EasySensors/ButtonSizeNode/pics/bttnsz.jpg

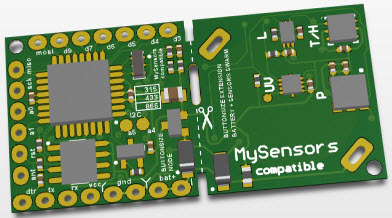
pics/bttnsz.jpg
