EasySensors/ButtonSizeNode/pics/bttnszH.jpg

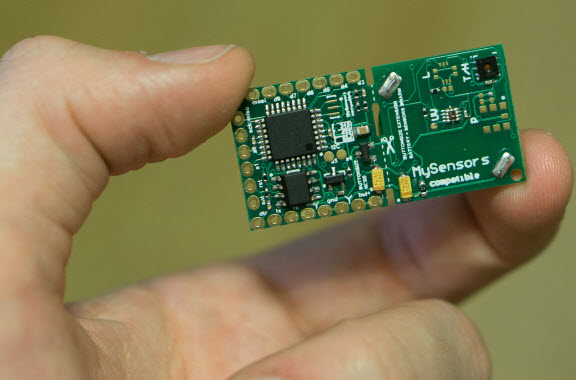
pics/bttnszH.jpg
