EasySensors/ButtonSizeNode/pics/cut.jpg

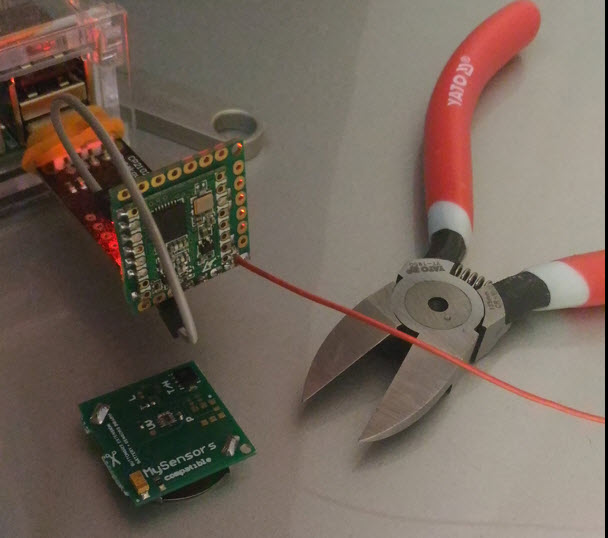
pics/cut.jpg
