EasySensors/ButtonSizeNode/pics/IMG_20180411_230300.jpg

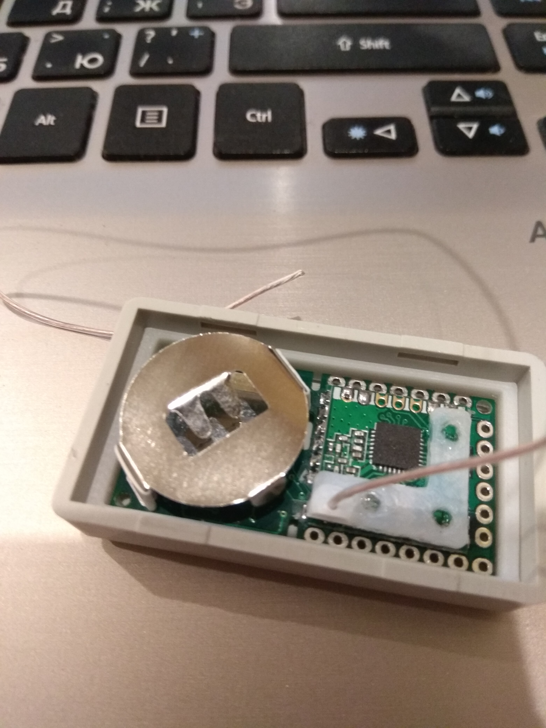
pics/IMG_20180411_230300.jpg
