EasySensors/ButtonSizeNode/pics/IMG_20180411_230850.jpg

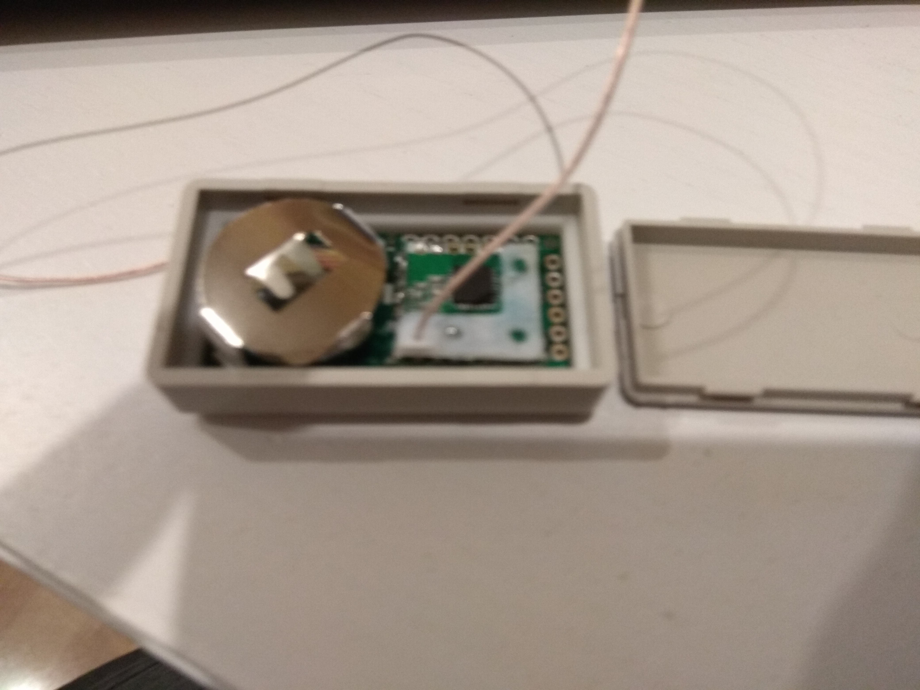
pics/IMG_20180411_230850.jpg
