EasySensors/ButtonSizeNode/pics/IMG_20180411_230931.jpg

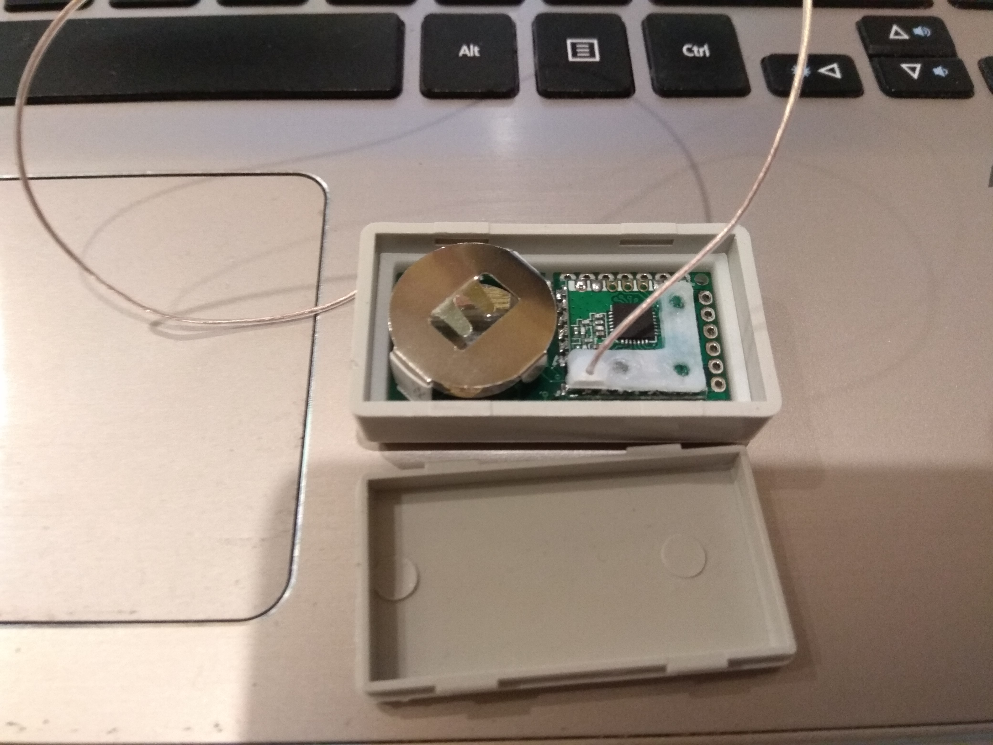
pics/IMG_20180411_230931.jpg
