EasySensors/ButtonSizeNode/pics/IMG_20180411_231010.jpg

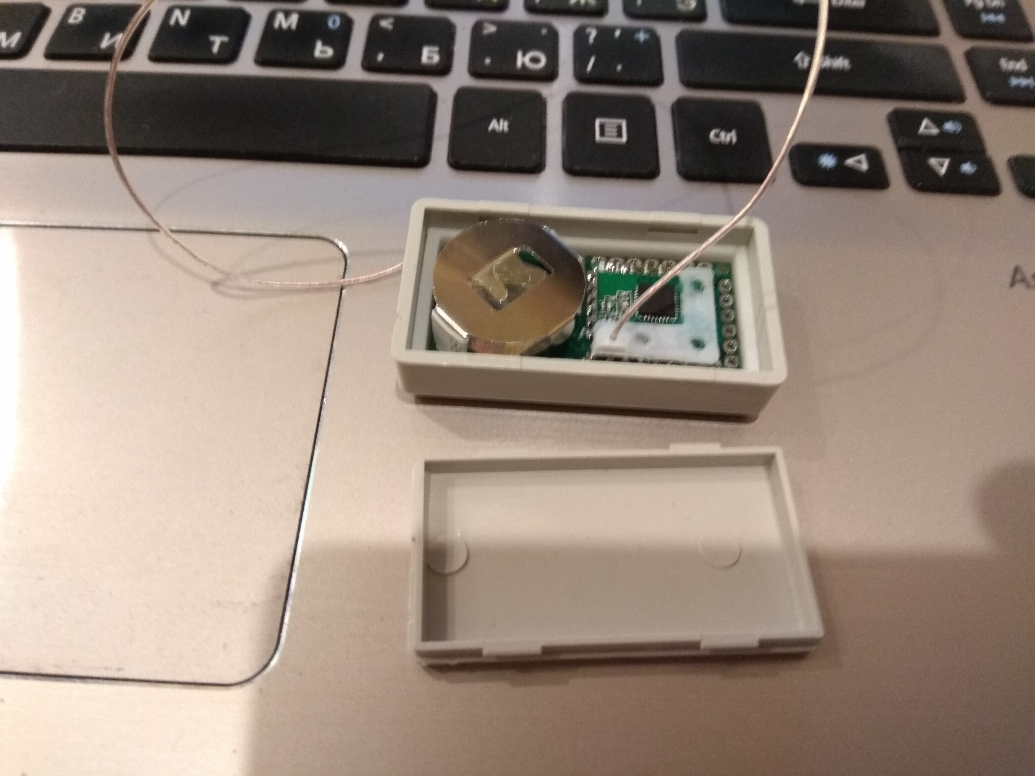
pics/IMG_20180411_231010.jpg
