EasySensors/ButtonSizeNode/pics/IMG_20180411_231150.jpg

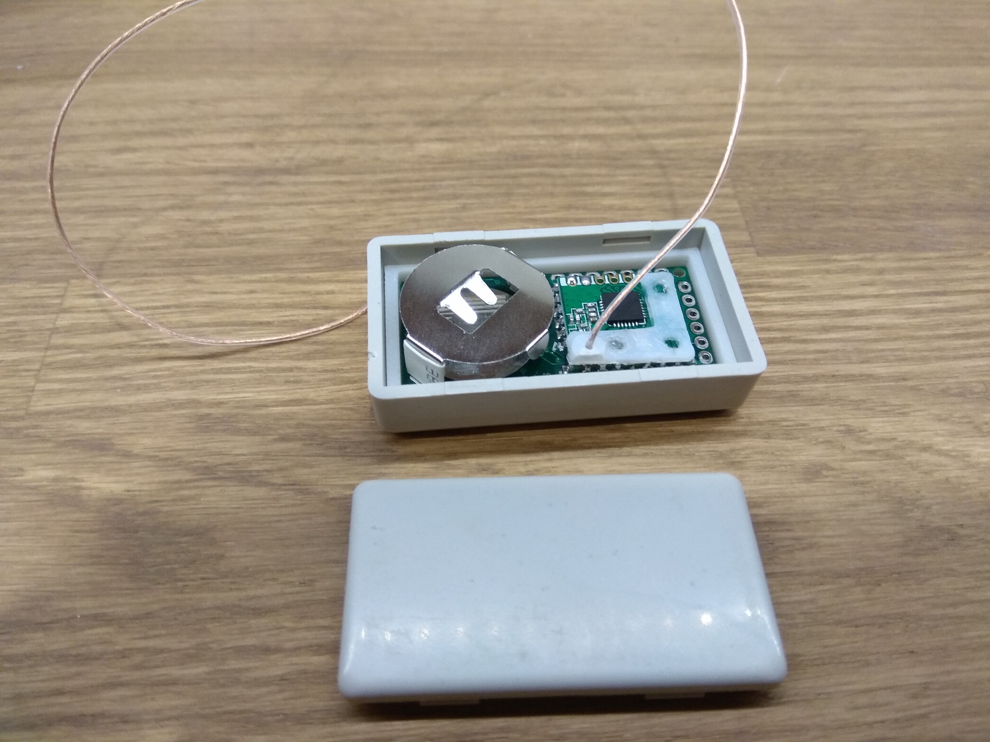
pics/IMG_20180411_231150.jpg
