EasySensors/ButtonSizeNode/pics/IMG_20180411_231150_cr.jpg

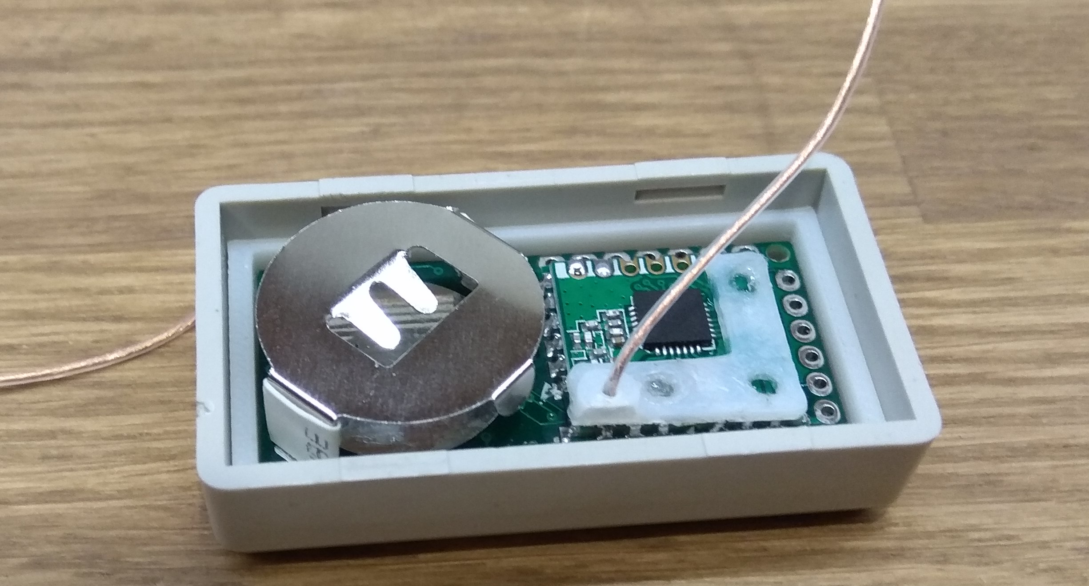
pics/IMG_20180411_231150_cr.jpg
