EasySensors/ButtonSizeNode/pics/IMG_20180411_231446.jpg

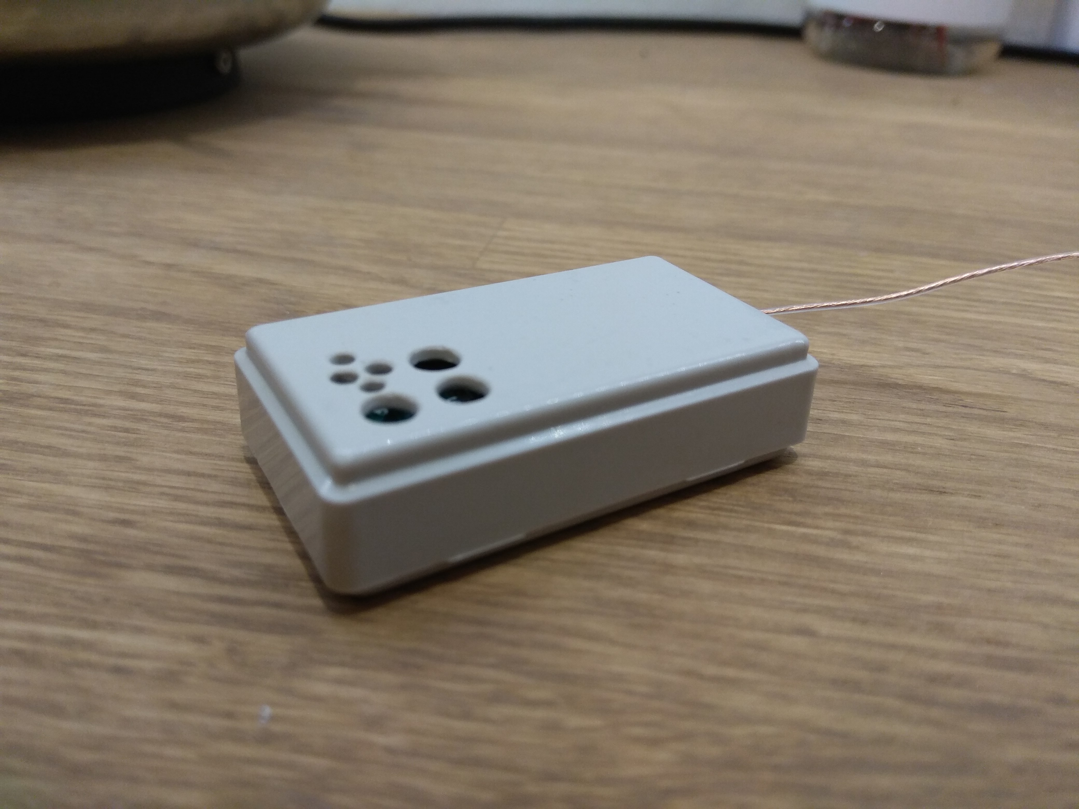
pics/IMG_20180411_231446.jpg
