EasySensors/ButtonSizeNode/pics/IMG_20180411_231446_cr.jpg

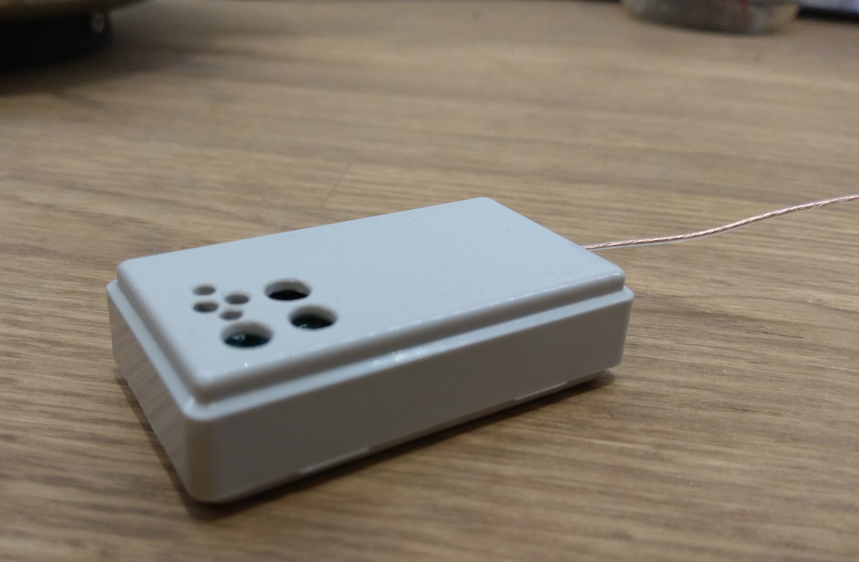
pics/IMG_20180411_231446_cr.jpg
