EasySensors/ButtonSizeNode/pics/personalization11.jpg

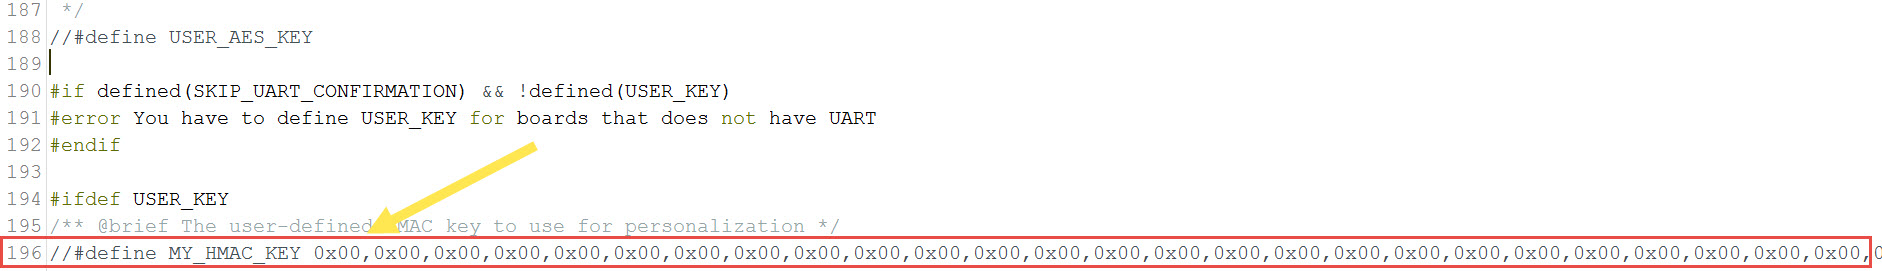
pics/personalization11.jpg
