EasySensors/ButtonSizeNode/pics/schematic.jpg

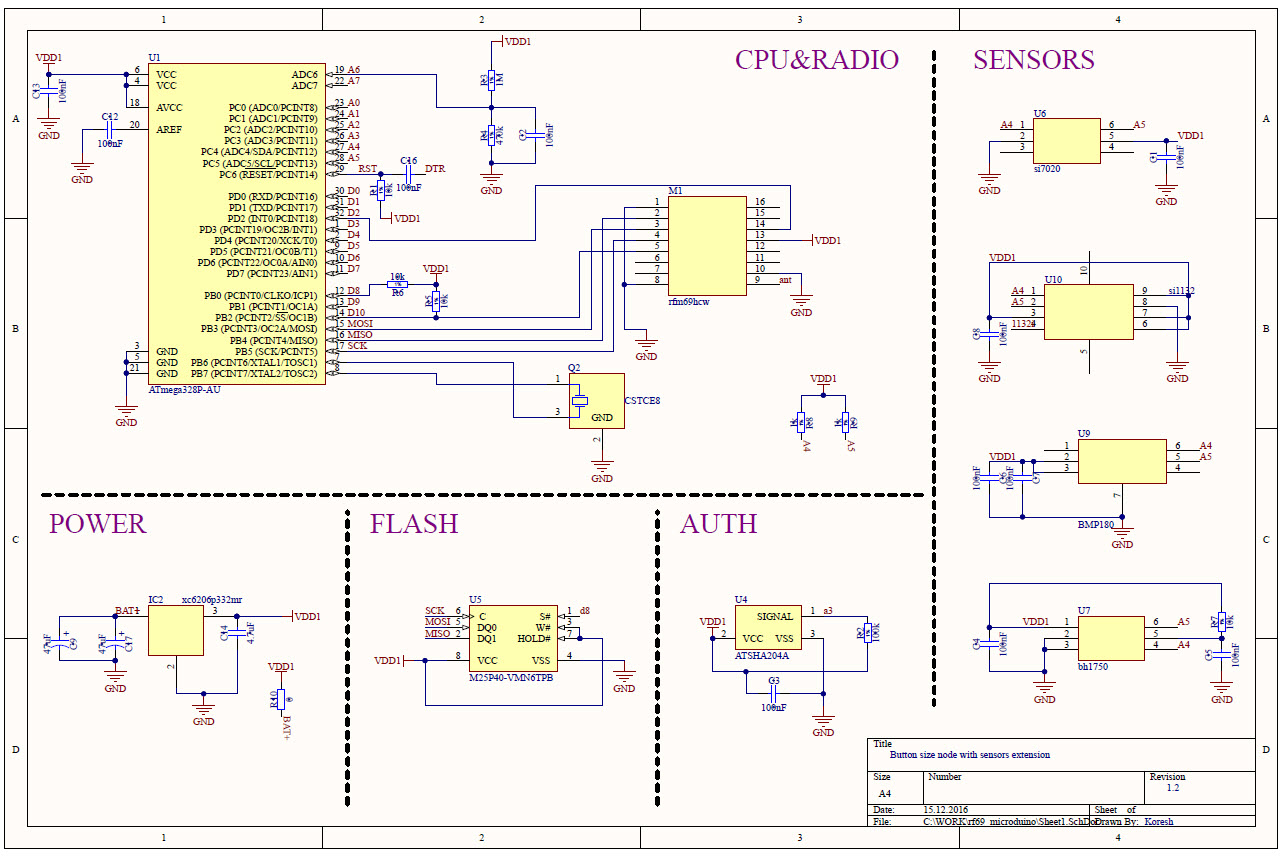
pics/schematic.jpg
