EasySensors/ButtonSizeNode/pics/Si7021.jpg

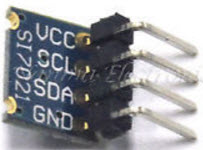
pics/Si7021.jpg
