EasySensors/ButtonSizeNode/pdf/ButtonSizeNodeNew.pdf

# CPU&RADIO SENSORS

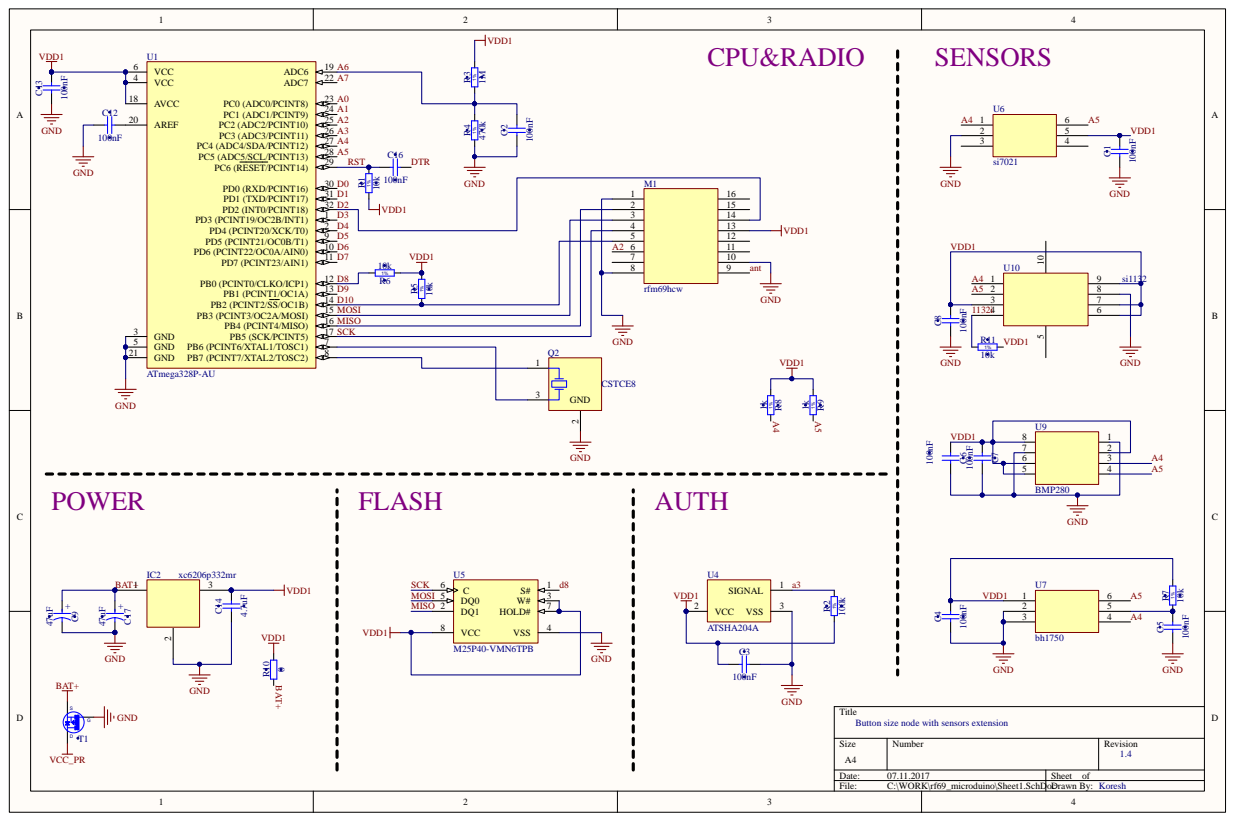
[picture p30: page 1]

Title
Button size node with sensors extension
