EasySensors/ButtonSizeNode/pdf/ButtonSizeNode_ext1.pdf

# CPU&RADIO SENSORS

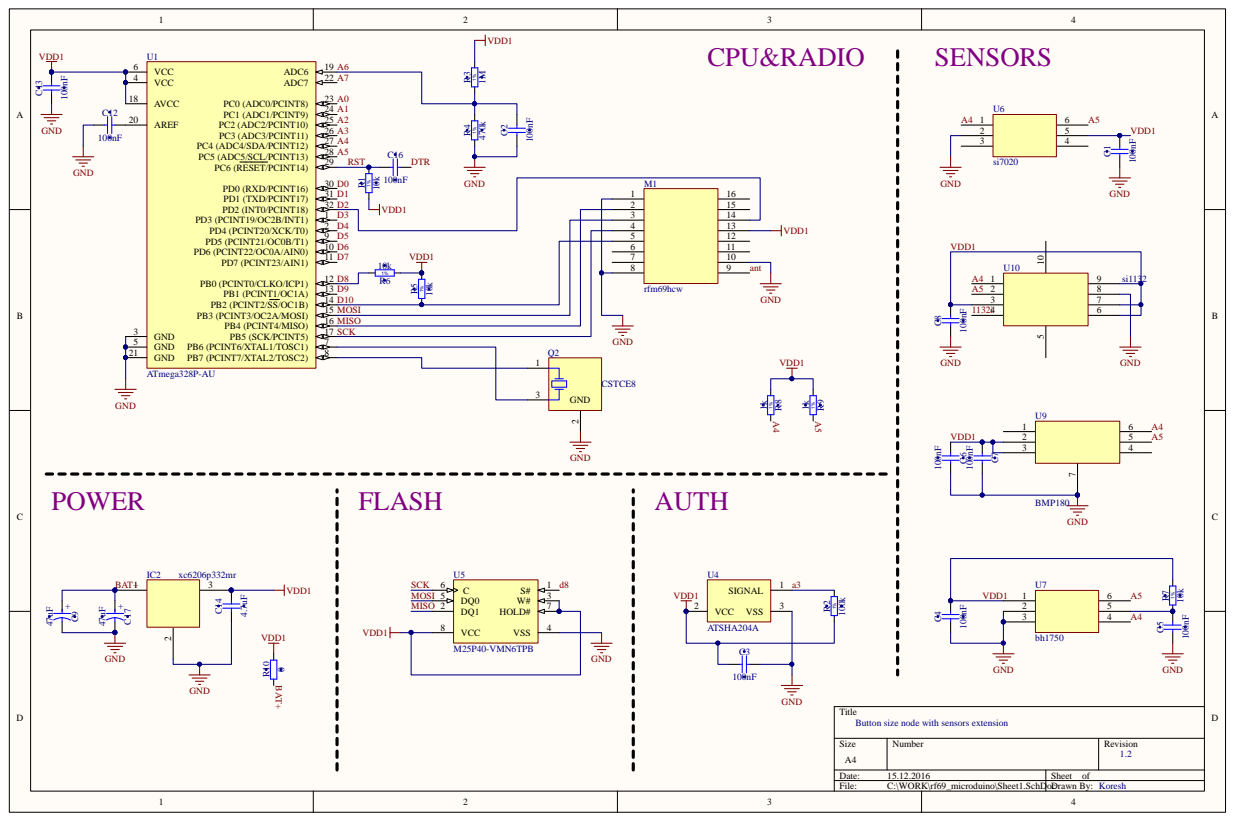
[picture p31: page 1]

Title
Button size node with sensors extension
