EasySensors/ButtonSizeNode/(commit log)

2017-05-28 Battery Percentage report
    battery 0 level reporting for CW and HCW radio versions
2017-06-26 cut off the node sensor part
2017-11-08 New Ver Schematics
    Added battery reverse polarity protection and a2 connected to RFM 69
    reset.
    [ButtonSizeNode.ino]
2018-01-28 noInterrupts(); in _flash.....
    /* Send JDEC to sleep
    * all of _flash.initialize(); _flash.sleep(); and _flash.wakeup();
    * need to be wrapped with noInterrupts(); - interrupts();
    */
2018-04-30 Create ODROID_Si1132_notes
    reduce current draw in sleep mode. odroid lib
2018-06-21 BH1750 init mode ONE TIME
    sends sensor to sleep after measure taken
2018-07-09 wait(100) before message send to ensure proper delivery
    this wait(); is RFM69 driver specific. Hope to get rid of it soon
2019-04-04 HCW to CW adapter Gerber files
