EasySensors/ButtonSizeNode/(notices)

Notices in the files:
ButtonSizeNode.ino:
modify it under the terms of the GNU General Public License
